ausilon/VLSI-Design/README.md

# VLSI Implementation of DPD for Next-Generation Digital TV Transmitters

Este repositório reúne o desenvolvimento de um sistema de pre-distorção digital
(Digital Predistortion, DPD) para transmissores de televisão digital de próxima
geração. O trabalho parte da geração de sinais OFDM em banda-base, passa pela
modelagem e treinamento do DPD, avança para a implementação em HDL e termina em
uma avaliação física preliminar com OpenLane e SKY130.

A motivação principal é estudar uma arquitetura digital capaz de compensar as
não linearidades de um amplificador de potência em um transmissor de TV digital.
O alvo de validação adotado é um sinal de canal de 6 MHz, representado como
banda-base complexa I/Q em 24 MS/s. Essa escolha permite trabalhar com uma taxa
compatível com o processamento digital do sinal e, ao mesmo tempo, manter margem
para observar distorções espectrais relevantes para DPD.

O projeto utiliza predominantemente ferramentas abertas e ferramentas acessíveis
em ambiente acadêmico. A geração de sinais foi feita com GNU Radio, a etapa de
treinamento utilizou OpenDPD, a verificação HDL foi conduzida no Questa Intel
FPGA Edition e a avaliação física foi preparada com OpenLane, OpenROAD, Yosys,
Magic, KLayout e o PDK aberto SKY130. Essa combinação foi adotada para permitir
reprodutibilidade, reduzir barreiras de acesso e manter o fluxo técnico
auditável por outros pesquisadores.

---

# Visão Geral do Fluxo

O fluxo foi organizado de forma incremental. Primeiro foi gerado um dataset em
banda-base complexa, usando uma cadeia ATSC 3.0 no GNU Radio como fonte de
excitação. Esse dataset foi convertido para os formatos usados tanto pelo
OpenDPD quanto pelos testbenches HDL. Em seguida, o OpenDPD foi usado para
treinar um modelo GMP e produzir coeficientes de referência. Esses coeficientes
foram quantizados em Q2.16 e aplicados ao motor HDL de inferência.

Na parte digital, o sistema foi dividido em três funções principais. O
`GMPengine` executa a inferência em tempo real e aplica a pre-distorção ao fluxo
I/Q. O `MetricEngine` observa potência, erro entre referência e feedback,
clipping e drift entre o sinal pre-distorcido e a referência. O `MACcore` executa
o treinamento interno em segundo plano, usando amostras capturadas da RAM e
atualizando o banco de coeficientes inativo.

Depois da validação funcional em simulação, os blocos foram preparados para
avaliação física em SKY130. A estratégia adotada foi modular: sintetizar e
avaliar primeiro os blocos menores, depois os blocos críticos de maior área
(`GMPengine` e `MACcore`) e, por fim, montar um top-level físico com macros.

---

# Organização do Repositório

A árvore pública mantém somente as versões finais selecionadas para revisão.
Versões intermediárias, diretórios de simulação compilados e runs completos de
OpenLane não são versionados. A evolução do trabalho é descrita nos documentos,
sem duplicar código antigo.

```text
Digital-Pre-Distortion/
├── HDL/
│   ├── rtl/          implementação HDL atual
│   ├── tb/           testbenches SystemVerilog
│   └── sim/          scripts Questa e vetores pequenos
├── gnu-radio/        flowgraph final usado para gerar o dataset ATSC 3.0
├── opendpd/          estudo algorítmico, contratos e figuras do treinamento
├── datasets/         datasets selecionados para reprodução
├── scripts/          conversão, quantização e exportação de coeficientes
├── openlane/         projetos OpenLane sem artefatos compilados
└── docs/             artigo, figuras, referências e estado técnico
```

---

# Geração do Dataset com GNU Radio

O dataset principal foi gerado a partir de uma cadeia ATSC 3.0 baseada no
projeto `gr-atsc3`, disponível em:

```text
https://github.com/drmpeg/gr-atsc3
```

O flowgraph usado como ponto de partida foi o exemplo `vv031.grc`. Ele foi
adaptado localmente para gerar um sinal em banda-base complexa adequado ao
treinamento DPD e à validação HDL. A entrada usada foi um arquivo de transporte
MPEG-TS (`sample_1280x720.ts`), e a saída foi convertida para amostras complexas
em 24 MS/s.

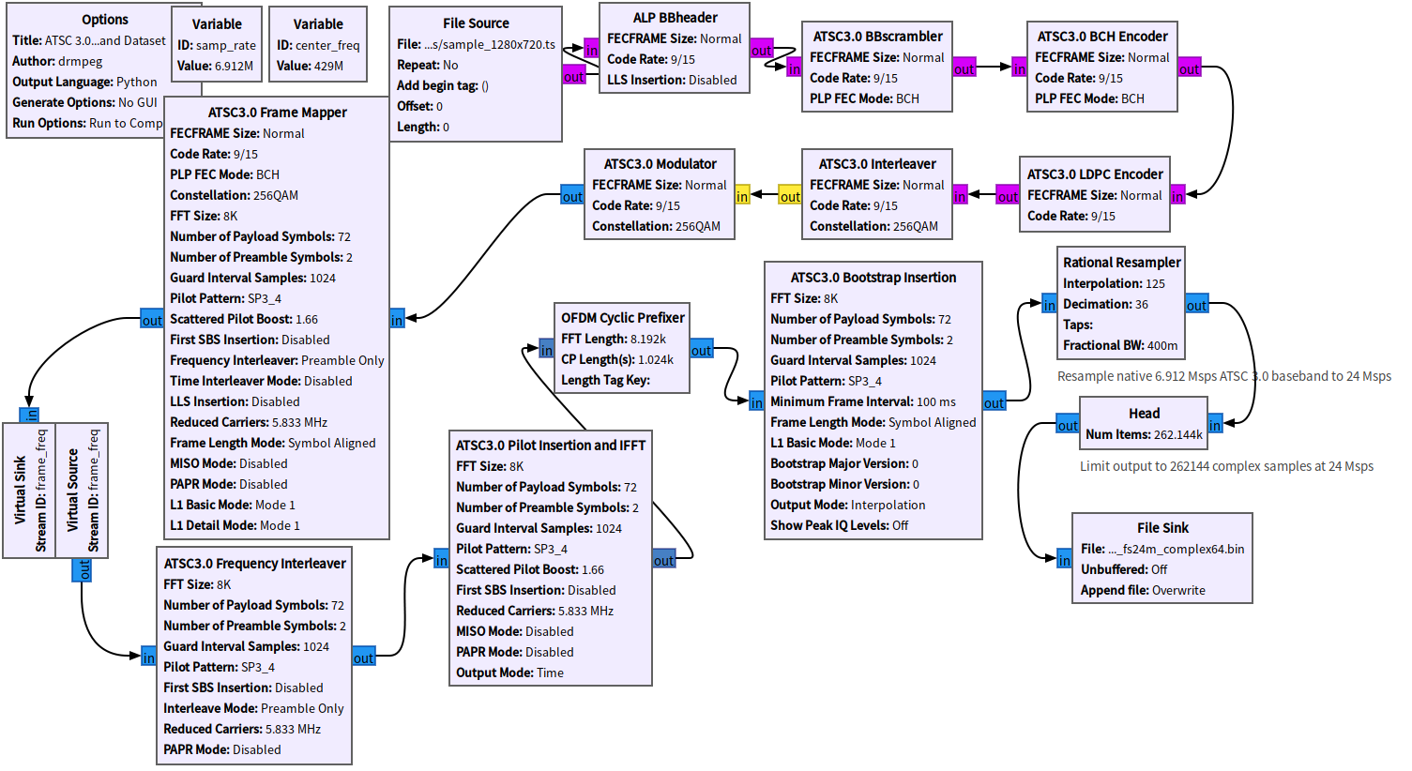
[picture p1: Digital-Pre-Distortion/docs/figures/gnuradio_atsc3_a322_vv031_flowgraph.png]
GNU Radio ATSC 3.0 flowgraph


O dataset resultante preserva os parâmetros principais do cenário estudado:
canal de 6 MHz, FFT 8K, modulação 256-QAM, amostragem de saída em 24 MS/s e
representação complexa I/Q. Para a simulação HDL, o mesmo sinal foi convertido
para Q1.15 e armazenado em arquivos `.hex`, mantendo nomes padronizados
(`ref_iq_q15.hex`, `feedback_iq_q15.hex` e capturas esperadas) para facilitar a
troca de datasets nos testbenches.

---

# Estudos Algorítmicos com OpenDPD

Antes da implementação em HDL, o comportamento do predistorter foi estudado no
ambiente OpenDPD. Essa etapa foi usada como referência matemática e experimental
para definir quais operações realmente precisariam existir no hardware. O fluxo
parte de um sinal I/Q em banda-base, passa esse sinal por um modelo de PA,
observa a distorção gerada e treina um bloco DPD para produzir uma versão
pre-distorcida da entrada. Quando essa versão pre-distorcida atravessa o mesmo
modelo de PA, a saída resultante deve se aproximar novamente do sinal linear
desejado.

No OpenDPD, essa separação deixa claro que existem dois problemas relacionados,
mas não idênticos. O primeiro é identificar ou aproximar o comportamento do PA.
O segundo é obter uma função inversa prática, isto é, um predistorter que
compense a compressão de ganho, a rotação de fase e os efeitos de memória do
amplificador. Para o trabalho em hardware, essa distinção foi importante porque
o PA completo não precisa ser implementado no caminho rápido do chip. O que
precisa operar em tempo real é o modelo DPD já treinado, enquanto a atualização
dos coeficientes pode ocorrer em background.

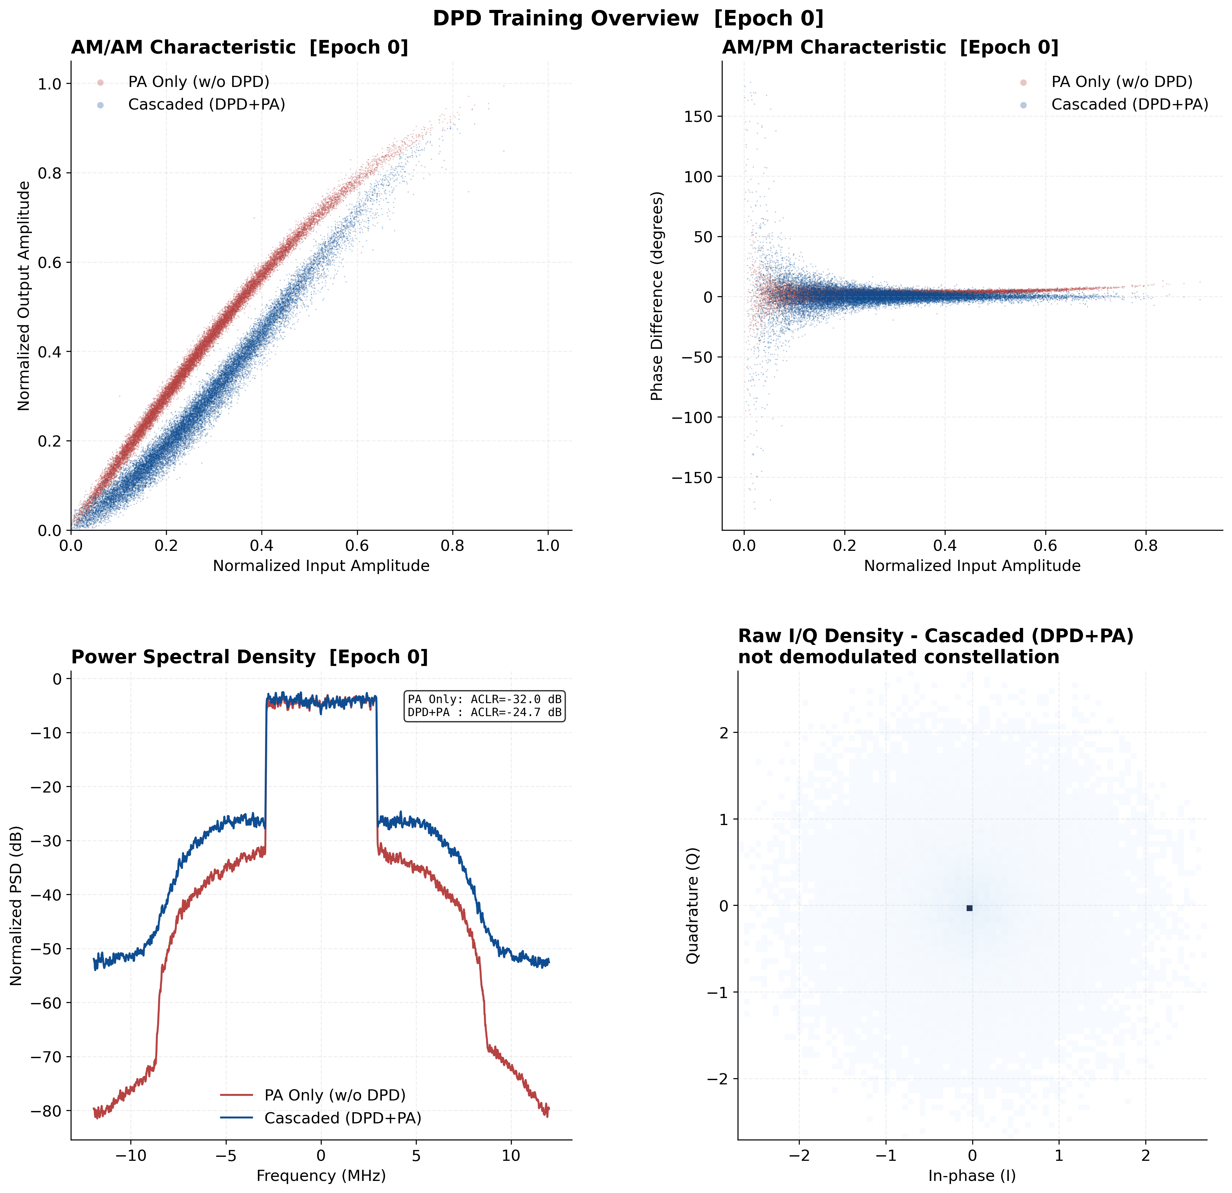
[picture p2: Digital-Pre-Distortion/opendpd/figures/overview_test.gif]
OpenDPD training overview


Os estudos iniciais compararam sinais DVB-T2 e ATSC 3.0, diferentes taxas de
amostragem e diferentes condições de PA. O resultado mais útil para a
arquitetura final veio do dataset ATSC 3.0/A/322 baseado no `vv031.grc`, com
saída em 24 MS/s. A escolha de 24 MS/s foi mantida porque representa quatro
vezes a largura do canal de 6 MHz, criando uma margem mais adequada para
observar componentes fora de banda e distorções de ordem mais alta. Nos testes
com banda passante menor, a resposta do DPD parecia melhorar algumas métricas,
mas a observabilidade espectral era limitada para uma análise robusta.

O algoritmo adotado para a sequência seguinte foi o GMP (Generalized Memory
Polynomial). Essa escolha equilibra três fatores. Primeiro, o GMP é uma família
de modelos conhecida em DPD para PAs com não linearidade e memória. Segundo, ele
é mais amigável para implementação digital que uma rede neural, pois pode ser
decomposto em atrasos, produtos, acumulações e bancos de coeficientes. Terceiro,
o próprio OpenDPD permitiu treinar e exportar uma configuração GMP que depois
poderia ser comparada contra a implementação HDL.

Na configuração registrada, o modelo de PA foi treinado como
`PA_S_0_M_GMP_H_23_F_64` e o predistorter como
`DPD_S_0_M_GMP_H_15_F_64_P_39`. O ponto mais importante para o HDL é o sufixo
`P_39`: ele consolidou a decisão de implementar 39 termos GMP. Como cada termo
usa coeficiente complexo, o contrato digital passou a exigir 39 pares de
coeficientes reais/imaginários, e não apenas coeficientes escalares reais. Essa
decisão aumentou a área do `GMPengine`, mas evitou validar uma versão
matematicamente mais fraca que não corresponderia ao modelo treinado no
OpenDPD.

O melhor resultado registrado para o dataset ATSC 3.0 em modo de PA mais
exigente ocorreu na época 12 de 15. O CSV final indicou, para validação,
`VAL_NMSE = -55,15 dB`, `VAL_EVM = -59,13 dB` e
`VAL_ACLR_AVG = -53,56 dB`. Para teste, os valores foram
`TEST_NMSE = -57,47 dB`, `TEST_EVM = -61,00 dB` e
`TEST_ACLR_AVG = -46,45 dB`. A diferença entre validação e teste no ACLR foi
mantida como observação de engenharia, pois o ACLR é sensível ao trecho do
sinal, à ocupação espectral instantânea e às janelas usadas na medição. Mesmo
assim, os resultados foram suficientes para definir o contrato algorítmico que
seria levado ao HDL.

A partir dessa etapa, os principais contratos definidos foram:

| Item | Contrato adotado no projeto |
|---|---|
| Amostras I/Q | signed Q1.15, 16 bits por componente |
| Coeficientes | signed Q2.16, 18 bits por componente |
| Modelo de inferência | GMP com 39 termos complexos |
| Dataset de referência | ATSC 3.0/A/322, 8K, 256-QAM, 24 MS/s |
| Entrada de simulação | arquivos `.hex` determinísticos para REF e FB |
| Saída esperada | vetores golden gerados a partir do modelo OpenDPD |
| Métricas de software | NMSE, EVM e ACLR |
| Métricas de hardware | potência L1, erro REF-FB, drift DPD-REF e clipping |

Essa tabela também explica por que os arquivos de simulação ainda carregam
referência e feedback separados. No transmissor físico, o feedback será obtido
da cadeia de observação após o PA. No ambiente de validação, entretanto, o
feedback precisa ser fornecido como arquivo para tornar a simulação reprodutível
e permitir checagem ciclo a ciclo. O uso de vetores golden também não significa
que o hardware dependa do OpenDPD em operação; ele significa apenas que uma
implementação HDL pode ser confrontada com uma referência algorítmica conhecida.

O OpenDPD também influenciou a divisão entre `GMPengine`, `MACcore` e
`MetricEngine`. O `GMPengine` implementa a inferência do modelo treinado e fica
no caminho rápido. O `MACcore` implementa o treinamento interno em tempo lento,
usando a RAM de captura e atualizando o banco de coeficientes inativo. O
`MetricEngine` não tenta reproduzir todas as métricas acadêmicas do OpenDPD em
tempo real. Ele calcula métricas mais simples e baratas em hardware, suficientes
para indicar degradação, clipping ou necessidade de novo treinamento. Métricas
como NMSE, EVM e ACLR continuam sendo adequadas para avaliação offline e
relatórios, mas seriam caras demais para colocar integralmente no caminho de
controle rápido de um ASIC compacto.

---

# Arquitetura Digital

O sistema inicia em bypass, pois no primeiro momento ainda não há coeficientes
válidos para compensar o PA. Enquanto o caminho rápido encaminha a referência, a
RAM de captura registra pares de referência e feedback. O `MACcore` utiliza esse
snapshot para treinar coeficientes. Quando o treinamento termina, o banco
inativo é atualizado e a troca de banco ocorre em evento síncrono, evitando
glitches no caminho de amostras.

Após a ativação do DPD, o `GMPengine` passa a operar no caminho rápido. O
`MetricEngine` continua acompanhando a qualidade do sinal e pode solicitar novo
treinamento quando as métricas ultrapassam os limiares configurados. O PicoRV32
permanece como elemento de controle e política, sem executar processamento
pesado de DSP.

O algoritmo de inferência é um GMP complexo. Para cada amostra central da janela
I/Q, o `GMPengine` calcula termos de base do tipo:

```text
phi_k[n] = x[n - m_x(k)] . |x[n - m_a(k)]|^p(k)
y[n]     = sum_k c_k . phi_k[n],  k = 0 ... 38
```

em que `x[n]` é a amostra complexa de referência, `c_k` é o coeficiente
complexo treinado e `p(k)` define a ordem não linear do termo. No HDL atual,
`x[n]` usa Q1.15, `c_k` usa Q2.16 e a saída é saturada novamente para Q1.15.

O treinamento interno usa uma forma block-NLMS por termo. A partir da captura
REF/FB, o `MACcore` monta a mesma base GMP e atualiza os coeficientes por:

```text
w_k <- w_k + mu . sum(e[n] . conj(phi_k[n])) /
             (epsilon + sum(|phi_k[n]|^2))
```

O `MetricEngine` usa métricas leves em hardware, sem FFT, divisão ou conversão
para dB. As principais são EWMA de magnitude L1 da saída DPD, EWMA do erro
REF-FB, EWMA do drift entre DPD e referência e contagem de clipping:

```text
power  <- power  - power/256  + (|dpd_i| + |dpd_q|)
error  <- error  - error/256  + (|ref_i - fb_i| + |ref_q - fb_q|)
drift  <- drift  - drift/256  + abs((|dpd_i| + |dpd_q|) - (|ref_i| + |ref_q|))
retrain_request = error > th_error or drift > th_drift or clipping > th_clip
```

O PicoRV32 executa a política de operação por meio de um mapa AXI-Lite. Pelo
firmware, ele pode habilitar o DPD e o bypass, iniciar captura e treinamento,
programar o alinhamento do feedback e os limiares das métricas, acessar os
bancos A/B, solicitar a troca sincronizada e consultar estados, métricas e
interrupções. O mapa completo de memória, registradores e campos está descrito
na seção [Mapa de Memória e Registradores do Subsistema
DPD](Digital-Pre-Distortion/HDL/README.md#mapa-de-memória-e-registradores-do-subsistema-dpd).

```text
bypass inicial
-> captura REF/FB
-> treinamento no MACcore
-> escrita no banco de coeficientes inativo
-> troca sincronizada de banco
-> inferência em tempo real no GMPengine
-> métricas e possível retreinamento
```

---

# Síntese Física e OpenLane

O fluxo físico foi estruturado por macros, seguindo a mesma estratégia modular
do HDL. Os blocos de controle e periféricos foram sintetizados separadamente,
enquanto RAM de captura e bancos de coeficientes foram tratados como macros com
SRAM. Essa separação evita que memórias grandes sejam implementadas
integralmente em flip-flops e permite estudar a ocupação física de cada bloco.

O `GMPengine` é o bloco de maior pressão de timing porque pertence ao caminho
rápido. A versão atual para OpenLane mantém os 39 termos GMP complexos,
amostras Q1.15 e coeficientes Q2.16. Dez lanes processam quatro grupos de termos,
resultando em intervalo de iniciação de quatro ciclos e throughput de
`Fclk/4`. Cada lane possui contrato de latência fixa e pipeline separado para
base GMP, produto, combinação complexa e alinhamento de saída. Em 100 MHz, essa
arquitetura fornece nominalmente 25 MS/s, acima do requisito de 24 MS/s. Esse é
o contrato arquitetural; a frequência física final depende do fechamento STA RCX
multicorner.

O `MACcore` usa a mesma base GMP no caminho lento e executa a atualização NLMS
sobre snapshots da RAM. A serialização é mais intensa porque o treinamento não
participa do datapath em tempo real. Após o registro da fronteira de leitura da
Capture RAM, a FSM recebeu dois ciclos explícitos de espera antes de consumir
cada palavra. O testbench golden foi repetido após essa alteração.

As duas memórias foram preparadas com fronteiras registradas, pin placement
orientado pelos ports das SRAMs e CTS específico. Elas possuem resultados
físicos posteriores ao global routing, mas esses resultados não são promovidos
isoladamente a signoff enquanto as oito macros não forem avaliadas no mesmo
checkpoint e com constraints completas.

O top-level experimental contém conectividade funcional entre as oito macros,
FIFOs elásticas nas fronteiras críticas, plano AXI-Lite interno e PDN
hierárquica. A baseline física publicada mantém die de `8,5 x 8,5 mm` e
clock-alvo de 100 MHz. As tentativas de integração do top ainda não produziram
fechamento uniforme de STA RCX multicorner. O contrato de encapsulamento
continua prevendo `aQFN/DRQFN-128`, mas o padframe físico, a análise de IR drop,
potência e o signoff do chip não fazem parte da baseline atual.

O floorplan foi refinado a partir de uma proposta manual de organização de
macros. A intenção foi manter o caminho rápido próximo ao `GMPengine`, posicionar
RAM e bancos de coeficientes entre inferência e treinamento, deixar o `MACcore`
na região inferior do núcleo e agrupar controle, métricas e periféricos na
lateral esquerda. Essa distribuição reduz cruzamentos desnecessários entre
datapath e controle e deixa espaço para uma futura etapa de padframe.

<table>
  <tr>
    <td align="center" width="50%">
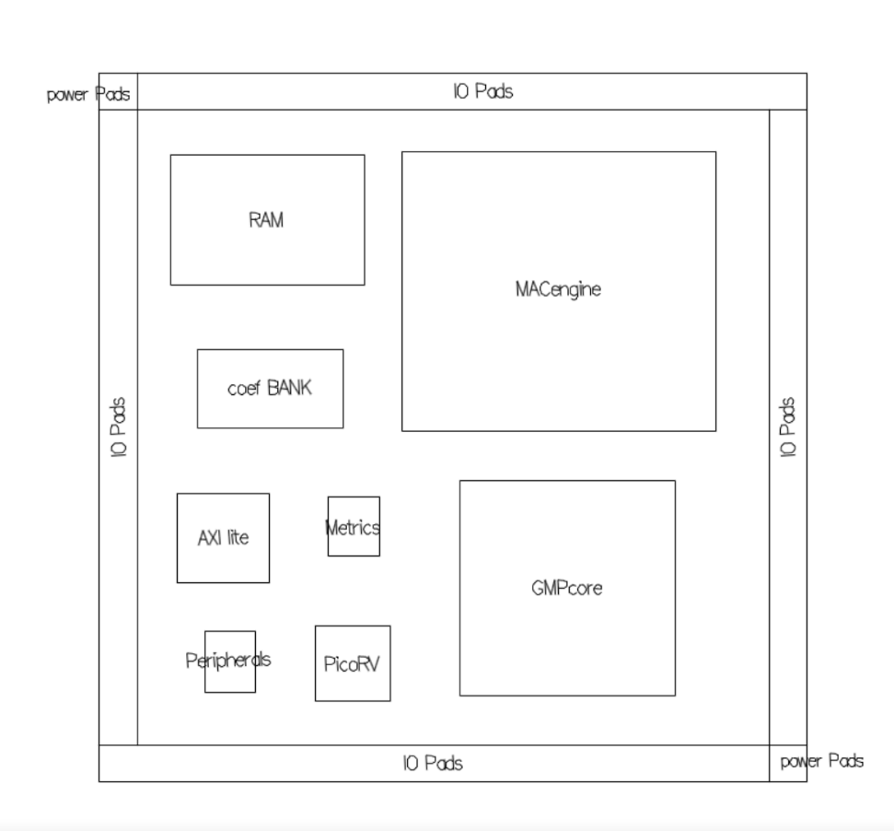
[picture p3: Digital-Pre-Distortion/docs/figures/dpd_foorplan.png]
      <br>
      <sub>Floorplan manual preliminar (<a href="Digital-Pre-Distortion/docs/figures/dpdv1_foorplan.pdf">PDF</a>).</sub>
    </td>
    <td align="center" width="30%">
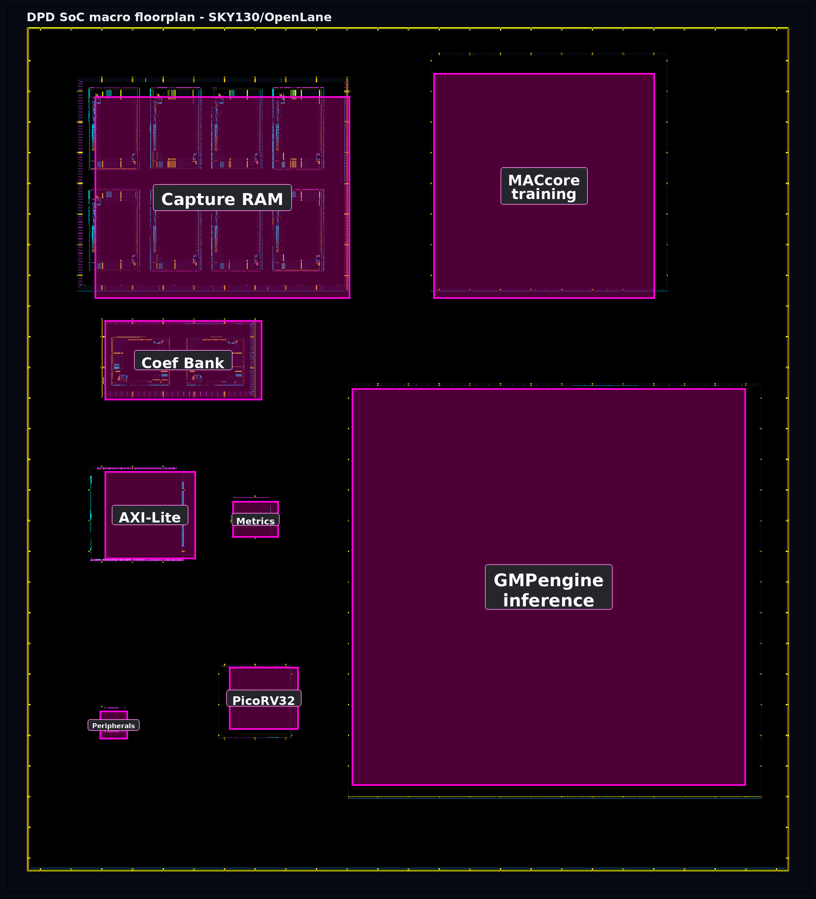
[picture p4: Digital-Pre-Distortion/docs/figures/dpd_soc_top_floorplan_v4.png]
      <br>
      <sub>Floorplan V4 usado como referência para a integração física (<a href="Digital-Pre-Distortion/docs/figures/dpd_soc_top_floorplan_v4.pdf">PDF</a>).</sub>
    </td>
  </tr>
</table>

A comparação seguinte foi nivelada no último checkpoint comum comprovado para
as oito macros: síntese mapeada, CTS, global routing e STA single-corner
pós-global-route com período-alvo de 10 ns. As contagens e a célula dominante
foram extraídas das netlists mapeadas pelo Yosys.

| Macro | Run auditado | Células | Área macro (mm²) | Setup pós-GRT (ns) | Hold pós-GRT (ns) | Dominante Cell |
|---|---|---:|---:|---:|---:|---|
| PicoRV32 | `signoff_100m_01` | 10.114 | 0,377 | +3,41 | +0,15 | `sky130_fd_sc_hd__buf_1` (2.422) |
| AXI control | `signoff_100m_01` | 1.713 | 0,640 | +3,58 | +0,21 | `sky130_fd_sc_hd__buf_1` (395) |
| Peripherals | `signoff_100m_01` | 755 | 0,044 | +4,21 | +0,19 | `sky130_fd_sc_hd__dfrtp_2` (183) |
| MetricEngine | `signoff_100m_01` | 2.593 | 0,116 | +2,94 | +0,24 | `sky130_fd_sc_hd__nand2_2` (272) |
| Capture RAM | `capture_ram_signoff_100m_13` | 741 (inclui 8 SRAM) | 4,140 | +3,93 | +0,26 | `sky130_fd_sc_hd__dfxtp_2` (320) |
| Coef Bank | `coef_bank_signoff_100m_04` | 154 (inclui 2 SRAM) | 0,845 | +1,84 | +1,65 | `sky130_fd_sc_hd__buf_1` (56) |
| GMPengine | `gmp_feature_piped_route_relaxed_100m_01` | 223.170 | 11,497 | +3,16 | +0,09 | `sky130_fd_sc_hd__nand2_2` (79.930) |
| MACcore | `mac_core_100m_05` | 131.048 | 7,758 | +1,47 | +0,16 | `sky130_fd_sc_hd__nand2_2` (35.921) |

## Resultado físico consolidado em 100 MHz

| Item | Resultado |
|---|---:|
| Clock-alvo das macros | 100 MHz (`10 ns`) |
| Checkpoint comum | STA single-corner pós-global-route |
| Macros niveladas | 8 |
| Menor setup observado | +1,47 ns (`MACcore`) |
| Menor hold observado | +0,09 ns (`GMPengine`) |
| GMPengine | `II=4`, throughput nominal de 25 MS/s a 100 MHz |
| Signoff uniforme do top | Não demonstrado |

Esses valores representam o melhor resultado comparável das macros isoladas no
alvo de 100 MHz. Eles não são combinados com resultados de runs posteriores em
outros períodos de clock e não demonstram que o top-level tenha fechado
temporização. O fechamento do top permanece dependente de constraints completas
e STA extraído multicorner.

Todas as oito macros possuem uma baseline comparável no checkpoint
pós-global-route. Resultados adicionais de detailed route, DRC, LVS e XOR
permanecem como evidências individuais e não são usados para elevar
seletivamente uma linha da tabela. Também não se declara Fmax a partir de WNS
intermediário: a frequência de operação será consolidada somente depois de
completar constraints e STA extraído multicorner na baseline física aprovada ou
no chip completo.

---

# Documentação Principal

- [Fluxo DPD](Digital-Pre-Distortion/README.md)
- [Arquitetura HDL](Digital-Pre-Distortion/HDL/README.md)
- [GNU Radio](Digital-Pre-Distortion/gnu-radio/README.md)
- [OpenDPD](Digital-Pre-Distortion/opendpd/README.md)
- [Datasets](Digital-Pre-Distortion/datasets/README.md)
- [OpenLane/SKY130](Digital-Pre-Distortion/openlane/README.md)
- [Trabalhos futuros](Digital-Pre-Distortion/docs/future_work.md)

---

# Política de Versionamento

O repositório mantém arquivos necessários para análise e reprodução do fluxo:
HDL, testbenches, scripts, flowgraphs, metadados, datasets selecionados,
configurações OpenLane e documentação. Não são versionados diretórios `runs/`,
bibliotecas `work/`, arquivos `.wlf`, GDS/LEF/DEF/SPICE/SDF/LIB gerados, logs
longos, caches e binários compilados.
