ausilon/VLSI-Design/Digital-Pre-Distortion/docs/figures/dpd_soc_top_floorplan_v4.pdf

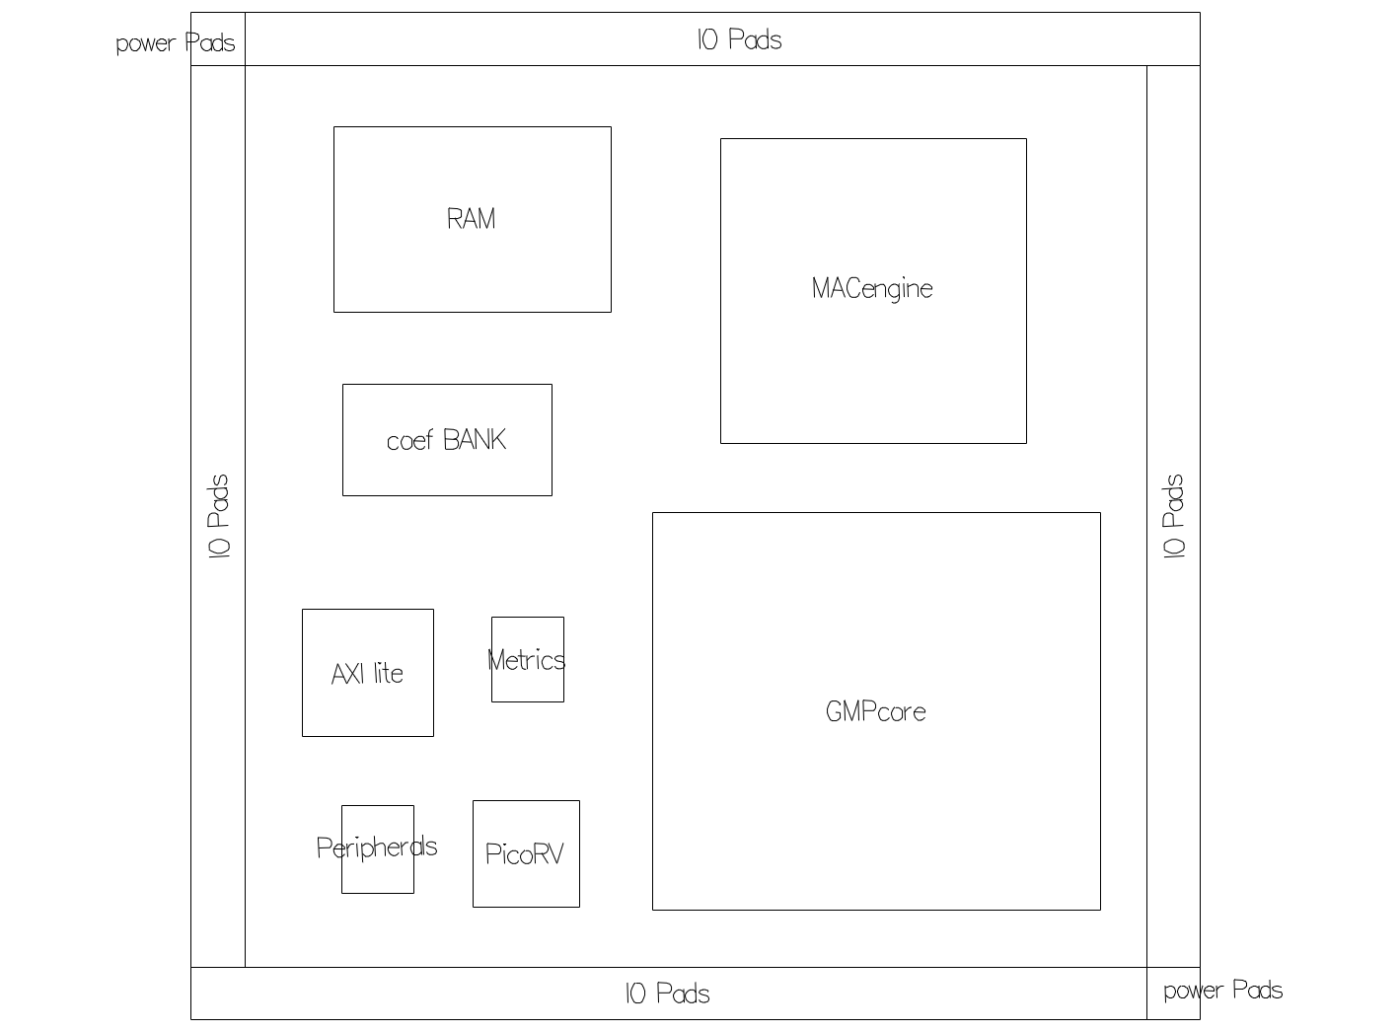
[picture p5: page 1]
