ausilon/VLSI-Design/Digital-Pre-Distortion/docs/figures/dpdv1_foorplan.pdf

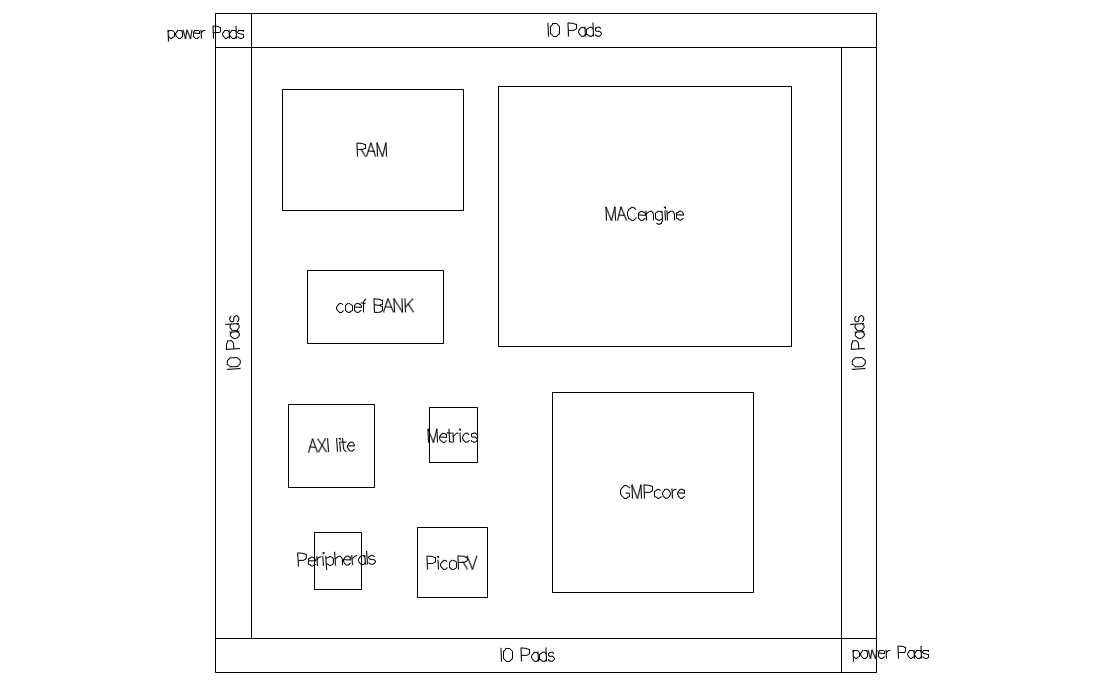
[picture p6: figure]
