ausilon/VLSI-Design/Digital-Pre-Distortion/article/VLSI_Implementation_of_DPD_for_Next_Generation_Digital_TV_Transmitters.pdf

# VLSI Implementation of DPD for Next-Generation Digital TV Transmitters

Ausilon V. Souza, Tarciso Gregório B. de Bello ausilon.souza@mtel.inatel.br, tarciso.gregorio@mtel.inatel.br Instituto Nacional de Telecomunicações – INATEL

Resumo—Este artigo apresenta o desenvolvimento de uma arquitetura HDL para Pré-Distorção Digital (Digital Predistortion – DPD) aplicada a transmissores de televisão digital de próxima geração. O trabalho considera como alvo tecnológico o contexto da TV 3.0 brasileira e adota, como sinal de referência inicial, uma forma de onda OFDM compatível com a família ATSC 3.0/A/322, canal de 6 MHz, modulação 256-QAM, FFT 8K e taxa de amostragem de 24 MS/s. A metodologia integra geração de dataset em GNU Radio, estudo algorítmico em OpenDPD, validação HDL no Questa e avaliação física preliminar em SKY130 por meio do OpenLane. O algoritmo adotado é um Generalized Memory Polynomial (GMP) com 39 termos complexos, amostras em ponto fixo Q1.15 e coeficientes em Q2.16. A arquitetura separa o caminho rápido de inferência, implementado pelo GMPengine, do caminho lento de captura, treinamento NLMS, atualização de coeficientes e supervisão por métricas. Os resultados consolidam o contrato algoritmo–HDL, demonstram validação funcional dos blocos críticos e apresentam uma baseline física comparável para oito macros no alvo de 100 MHz. A integração física final do top-level, o padframe com proteção ESD e o fechamento temporal pós-extração permanecem como trabalhos futuros.

Index Terms—Digital Predistortion, DPD, VLSI, Digital TV, TV 3.0, ATSC 3.0, GMP, NLMS, HDL, SKY130, OpenLane, GNU Radio, OpenDPD.

I. INTRODUÇÃO
O

trabalho apresentado neste artigo propõe o desenvolvimento de um hardware dedicado para aplicações em telecomunicações, com foco específico na implementação de um sistema de Pré-Distorção Digital (Digital Predistortion – DPD). A arquitetura desenvolvida foi concebida considerando os requisitos impostos pelos sistemas de radiodifusão de televisão digital de nova geração, em especial o padrão TV 3.0, cuja adoção representa um importante avanço tecnológico ao incorporar novas técnicas de modulação, codificação e transmissão de sinais. Nesse contexto, a crescente complexidade dos algoritmos de processamento digital de sinais exige soluções computacionais capazes de operar em tempo real, com elevada eficiência energética e reduzida latência, tornando o desenvolvimento de arquiteturas dedicadas uma alternativa de grande relevância para aplicações práticas.
Uma das premissas fundamentais deste trabalho consiste na adoção de um fluxo de desenvolvimento baseado predominantemente em ferramentas, frameworks e ambientes de desenvolvimento de código aberto. Essa escolha está diretamente relacionada à necessidade de tornar o processo de pesquisa mais acessível, transparente e reprodutível. No campo da microeletrônica e do projeto de circuitos integrados, grande parte das ferramentas de projeto eletrônico (Electronic Design Automation – EDA) é disponibilizada apenas por meio de licenças comerciais de alto custo, geralmente restritas a grandes empresas e centros de pesquisa. Essa realidade representa uma barreira significativa para universidades, laboratórios independentes e pesquisadores, limitando o acesso às tecnologias mais modernas e dificultando a formação de novos profissionais na área.

Nos últimos anos, entretanto, observa-se um crescimento expressivo do ecossistema de ferramentas abertas para projeto de hardware digital. Esse movimento tem possibilitado a realização de fluxos completos de desenvolvimento utilizando soluções livres, abrangendo desde a descrição do hardware até as etapas de síntese lógica, posicionamento físico, roteamento, geração de layout e verificação do projeto. Além de reduzir custos, essa abordagem favorece a reprodutibilidade científica, permitindo que outros pesquisadores validem, reproduzam e estendam os resultados apresentados.

No fluxo de desenvolvimento adotado neste trabalho, a descrição do hardware foi realizada utilizando linguagem HDL, empregando ferramentas da Siemens EDA disponibilizadas por meio de licença acadêmica estudantil para validação funcional. Após a descrição do hardware, as etapas de síntese lógica, planejamento físico, posicionamento, roteamento e verificação física foram avaliadas utilizando o framework OpenLane, que integra ferramentas como Yosys, OpenROAD, Magic e Netgen ao PDK aberto SKY130 [1], [2]. A modelagem comportamental do amplificador de potência e o treinamento do DPD foram conduzidos no OpenDPD [3], [4], enquanto a geração do sinal em banda-base foi feita em GNU Radio [5], a partir de uma cadeia ATSC 3.0 disponível no projeto gr-atsc3 [6].

A integração dessas ferramentas demonstra que é possível estabelecer um fluxo completo de desenvolvimento para sistemas de processamento digital de sinais voltados às telecomunicações utilizando predominantemente tecnologias abertas. Além de reduzir custos, essa abordagem promove maior transparência metodológica, facilita a reprodutibilidade dos experimentos e incentiva a colaboração entre pesquisadores. Dessa forma, o presente trabalho busca apresentar uma arquitetura dedicada para implementação de DPD aplicada ao contexto da TV 3.0 e, simultaneamente, registrar os contratos algorítmicos, numéricos e físicos necessários para levar esse tipo de algoritmo a uma implementação VLSI.

II. OBJETIVO E CONTRIBUIÇÕES
O objetivo principal deste trabalho é desenvolver e validar uma arquitetura HDL de DPD capaz de operar como bloco dedicado em um transmissor de televisão digital de próxima geração. Nesta etapa, o foco é consolidar a transição entre o algoritmo treinado em alto nível e uma implementação sintetizável, com atenção especial à quantização, ao particionamento entre caminho rápido e caminho lento, à validação por testbenches e à estimativa física em SKY130.
As principais contribuições desta versão do trabalho são:
- definição de um fluxo de dataset para DPD baseado em GNU Radio e em forma de onda ATSC 3.0/A/322, com canal de 6 MHz e taxa de 24 MS/s;
- estudo algorítmico em OpenDPD para seleção de um modelo GMP com 39 termos complexos e avaliação por NMSE, EVM e ACLR;
- consolidação do contrato numérico em Q1.15 para amostras I/Q e Q2.16 para coeficientes complexos;
- implementação HDL dos blocos GMPengine, MACcore com treinamento block-NLMS e MetricEngine com métricas L1/EWMA;
- validação funcional em Questa com vetores derivados do OpenDPD e testbenches de integração;
- avaliação física preliminar em OpenLane/SKY130, nivelando oito macros individuais no checkpoint comum de STA single-corner pós-global-route com alvo de 100 MHz.

III. SINAL DE REFERÊNCIA E DATASET

A especificação brasileira TV 3.0 é tratada neste trabalho como alvo tecnológico de longo prazo. Os documentos do Fórum SBTVD e os relatórios da fase 3 indicam a adoção de uma camada física compatível com a família ATSC 3.0, incluindo conceitos presentes nos documentos A/300, A/321, A/322 e A/324 [7]–[13]. A norma brasileira ABNT NBR 25601:2025 aparece como referência formal de camada física no catálogo da ABNT [14].
Para avançar antes da disponibilidade de uma cadeia completa de transmissão TV 3.0 em hardware, foi adotado um sinal OFDM de referência inspirado no perfil físico ATSC 3.0/A/322. O dataset principal foi gerado no GNU Radio a partir do projeto gr-atsc3, usando como base o exemplo vv031.grc. Esse fluxo inclui blocos de processamento típicos da cadeia física, como scrambler, codificação BCH/LDPC, interleaving, mapeamento, inserção de pilotos, bootstrap e formação OFDM. A entrada utilizada foi um arquivo de transporte MPEG-TS, e a saída foi salva como banda-base complexa. A figura do flowgraph completo foi omitida nesta versão por legibilidade, mas o papel técnico da cadeia permanece o mesmo: produzir um estímulo I/Q compatível com o cenário de radiodifusão estudado e reprodutível por terceiros no GNU Radio.
O dataset final possui FFT 8K, modulação 256-QAM, canal de 6 MHz e taxa de saída de 24 MS/s. A taxa de 24 MS/s foi escolhida por representar quatro vezes a largura de canal de 6 MHz, oferecendo margem para observar componentes fora de banda e distorções não lineares relevantes ao DPD.

Após a geração em ponto flutuante, o sinal foi convertido para arquivos usados pelo OpenDPD e para arquivos .hex em Q1.15 usados nos testbenches HDL. Em simulação, os arquivos de referência e feedback são mantidos separados para tornar o experimento determinístico; em hardware real, o feedback será produzido pela cadeia de observação após o PA.

IV. ESTUDO ALGORÍTMICO COM OPENDPD
Antes da implementação HDL, o OpenDPD foi utilizado como ambiente de referência para estudar o comportamento do PA e do predistorter. Essa etapa separa dois problemas: identificar ou aproximar a resposta do amplificador e obter uma função inversa prática capaz de compensar compressão de ganho, rotação de fase e efeitos de memória. O PA completo não é implementado no caminho rápido do chip; o que precisa operar em tempo real é o modelo DPD treinado, enquanto a atualização dos coeficientes pode ocorrer em background.
O algoritmo selecionado foi o Generalized Memory Polynomial (GMP). A escolha foi motivada por três fatores. Primeiro, o GMP é uma classe conhecida para DPD em PAs com não linearidade e memória. Segundo, sua estrutura pode ser implementada com atrasos, magnitudes, produtos complexos e acumulações, o que é mais direto para HDL do que modelos neurais densos. Terceiro, o OpenDPD permitiu treinar e exportar uma configuração GMP que pôde ser comparada contra a implementação inteira em hardware.
Na configuração consolidada, o PA foi treinado como PA_S_0_M_GMP_H_23_F_64 e o predistorter como DPD_S_0_M_GMP_H_15_F_64_P_39. O parâmetro P_39 definiu a implementação de 39 termos GMP. Como cada termo utiliza coeficiente complexo, a arquitetura passou a exigir pares real/imaginário para cada coeficiente, e não apenas coeficientes reais escalares.
O melhor ponto registrado ocorreu na época 12 de 15. A Tabela I mostra os resultados extraídos do CSV final. A diferença entre validação e teste no ACLR foi mantida como observação técnica, pois o ACLR é sensível ao trecho temporal avaliado, à ocupação espectral instantânea e à janela de medição.

Tabela I: Resultados do DPD GMP no OpenDPD para o dataset ATSC 3.0/A/322.

Conjunto | NMSE (dB) | EVM (dB) | ACLR médio (dB)
Validação | -55.15 | -59.13 | -53.56
Teste | -57.47 | -61.00 | -46.45
V. ARQUITETURA DIGITAL PROPOSTA
A Fig. 2 apresenta a arquitetura funcional. O sistema foi estruturado em dois caminhos. O caminho rápido contém o GMPengine, responsável pela inferência DPD em tempo real. O caminho lento contém captura de amostras, treinamento, atualização dos bancos de coeficientes e supervisão. Essa separação evita que o treinamento, que pode demandar janelas temporais muito maiores que o período de amostragem, interfira no fluxo contínuo de transmissão.

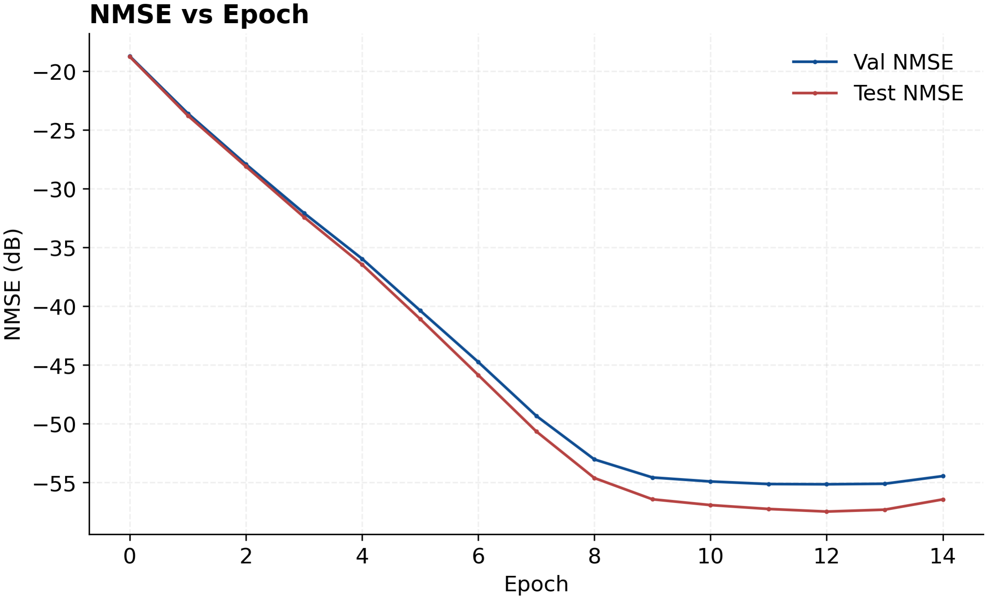
[picture p7: figure]
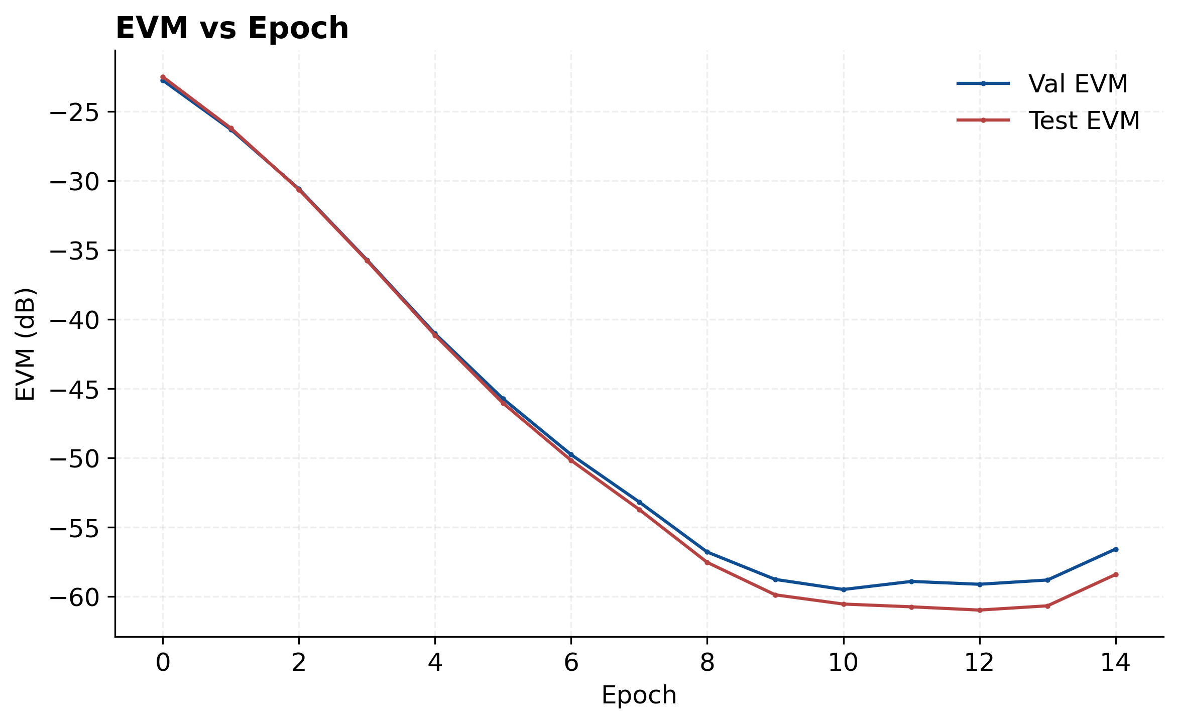
[picture p8: figure]
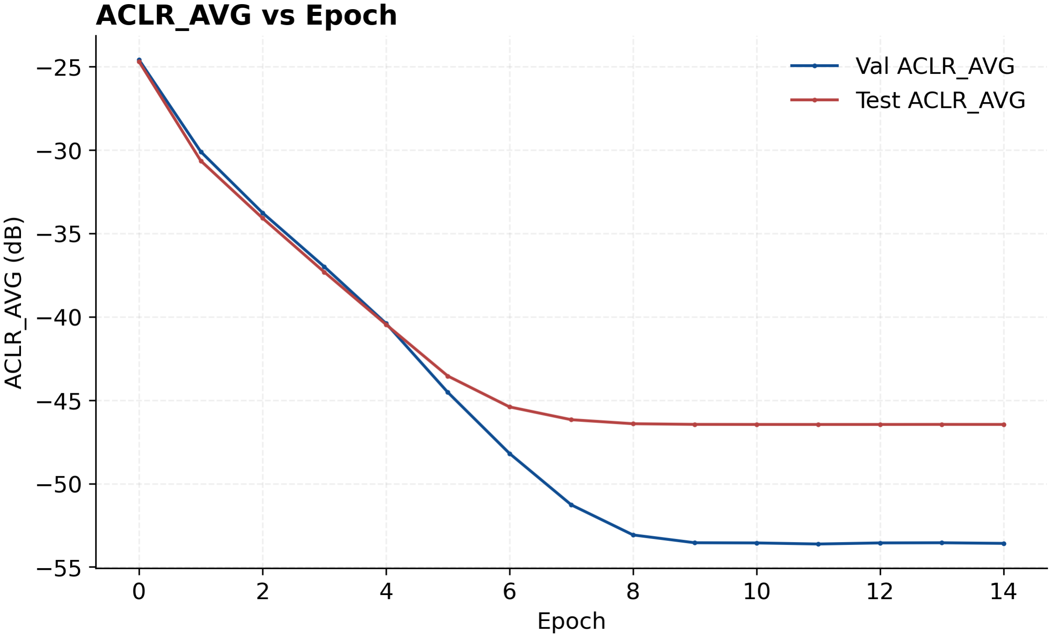
[picture p9: figure]

(a) NMSE por época. | (b) EVM por época. | (c) ACLR médio por época.

Figura 1: Curvas de treinamento obtidas no OpenDPD para o dataset ATSC 3.0/A/322 8K 256-QAM em 24 MS/s.

No diagrama, o bloco PA representa uma abstração do
caminho de transmissão analógico/RF observado pelo sistema de DPD. Portanto, além do amplificador de potência propriamente dito, esse bloco inclui efeitos equivalentes de conversão digital-analógica, filtragem de reconstrução, upconversion, cadeia RF, acoplamento de feedback, downconversion e conversão analógico-digital, quando observados no domínio de banda-base complexa. O modelo usado pelo DPD não busca descrever cada estágio físico individualmente, mas a relação comportamental equivalente entre o sinal de referência aplicado ao transmissor e o sinal de feedback medido após a cadeia RF.

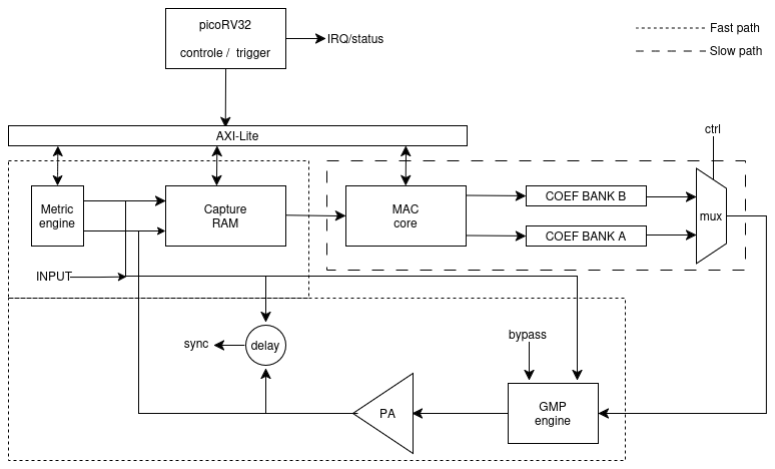
[picture p10: figure]

Figura 2: Diagrama funcional da arquitetura DPD com caminho rápido de inferência e caminho lento de captura/treinamento.

Durante a inicialização, o transmissor opera em bypass porque ainda não há coeficientes treinados. Nessa fase, a RAM de captura registra pares de referência e feedback. O MACcore lê esse snapshot e executa treinamento block-NLMS sobre a mesma base GMP usada na inferência. Ao final do treinamento, os coeficientes são gravados no banco inativo. A troca de banco ocorre apenas em evento de sincronismo, evitando descontinuidade no caminho de amostras.

VI. FORMULAÇÃO MATEMÁTICA PARA HDL

As amostras complexas são representadas por

x[n] = xi[n] + jxq [n], | (1)

com componentes signed Q1.15. Os coeficientes complexos do DPD são
ck = ak + j bk, | (2)

armazenados em signed Q2.16. Cada termo GMP ocupa dois endereços no banco de coeficientes:

addr(2k) = ℜ{ck }, | addr(2k + 1) = ℑ{ck }. | (3)
A. GMPengine
O modelo implementado pelo GMPengine é:

y[n] =

Õ
38

k=0

ckφk [n], | (4)

em que
φk [n] = xmx (k) [n]
xma (k) [n]
p(k)
| | | | | . | (5)
O | bloco | utiliza | uma janela | de | cinco | amostras
{x0, x1, x2, x3, x4}, sendo x2 | a amostra central associada
à saída validada. As posições x3 e x4 preservam o lookahead de duas amostras herdado do contrato OpenDPD. O conjunto de termos possui três termos lineares, com p = 0, e 36 termos não lineares, com p = 1, 2, 3, 4. Para cada ordem não linear são usadas nove combinações de posição:

(mx, ma) ∈ {(0, 0), (1, 1), (2, 2),
(0, 1), (1, 2), (2, 3),
(0, 2), (1, 3), (2, 4)}.
| | | | | | (6)

A magnitude é calculada por raiz inteira:

|xm| =

q

x

2
i,m + x

2
q,m, | (7)

e as potências são mantidas em escala Q1.15. Para p > 0,

φi =

xi,mx

|xma

p

2

15 | , | φq =

xq,mx

|xma

p

2

15 | . | (8)

A multiplicação complexa de cada termo é:

yi ← yi +

φiak − φqbk

2

16 | ,

yq ← yq +

φibk + φqak

2

16 | .

(9)

O deslocamento por 2

16 corresponde à escala Q2.16 dos coeficientes. Após a soma dos 39 termos, a saída é saturada para Q1.15.

B. MACcore e Block-NLMS

O MACcore usa o feedback como base de regressão e a referência como alvo. Para cada amostra capturada,

φk [n] = f bmx (k) [n]

f bma (k) [n]
p(k)
. | (10)

O modelo corrente estima:

yˆ[n] =

Õ
38

k=0

wkφk [n], | (11)

e o erro de modelo é:

e[n] = re f [n] − yˆ[n]. | (12)

Para cada termo, o treinamento acumula:

Nk =

Õ

n

e[n]φ

∗
k
[n], | (13)

Dk =

Õ

n

|φk [n]|²
. | (14)

A atualização block-NLMS aplicada é:
wk ← satQ2.16

wk + μ

Nk

ε + Dk

. | (15)

No HDL atual, ε = 1 e μ = 1/4, implementado por deslocamento de dois bits. O treinamento executa até 20 épocas, mantendo o melhor conjunto de coeficientes pela norma L1 do erro:

Ee pocℎ =

Õ

n

(|ℜ{e[n]}| + |ℑ{e[n]}|) . (16)

Após pelo menos 10 épocas, o treinamento pode parar antecipadamente caso o erro da época atual fique pior que o melhor erro observado.

C. MetricEngine

O MetricEngine calcula métricas leves, sintetizáveis e adequadas ao plano de controle. A magnitude L1 da saída DPD é:

magd pd [n] = |dpdi[n]| + |dpdq [n]|. | (17)

O erro REF-FB é:

errL1 [n] = |re fi[n] − f bi[n]| + |re fq [n] − f bq [n]|. (18)

O drift entre esforço de predistorção e referência é:

dri f tL1 [n] =

magd pd [n] − (|re fi[n]| + |re fq [n]|)
. (19)

As métricas são atualizadas por EWMA com fator 1/256:

M ← M −

M
256 + v[n]. | (20)

Esses valores não são expressos em dB; em regime permanente, aproximam 256 vezes a média L1 do sinal observado. O pedido de retreinamento é gerado por:

retrain = metrics_valid ∧ (metric_error > tℎe∨

metric_dri f t > tℎd∨ metric_cli p ping > tℎc). | (21)

VII. VALIDAÇÃO HDL

A validação foi conduzida no Questa, usando testbenches SystemVerilog. O fluxo foi construído de forma incremental: primeiro foram validados periféricos, bancos de coeficientes, captura e alinhamento; em seguida, os blocos críticos GMPengine, MetricEngine e MACcore; por fim, o fluxo completo em dpd_top.
O contrato OpenDPD–HDL foi validado por arquivos .hex. O banco coef_bank_openDPD.hex contém 78 palavras úteis, em formato real/imaginário, e margem até 128 posições. As amostras e saídas esperadas são armazenadas em Q1.15. O testbench do GMPengine carrega os coeficientes, aplica o dataset e compara a saída HDL com vetores calculados no mesmo modelo inteiro usado para validação. O teste integrado exercita a sequência:

bypass -> captura -> treino -> coeficientes -> sync -> DPD ativo -> métricas -> retreino.

A validação das métricas permite alternar entre DPD desabilitado e DPD ativo. Em bypass, a saída observada se aproxima da referência e as métricas de drift tendem a valores baixos. Com DPD ativo, as métricas passam a observar o esforço de predistorção aplicado pelo GMPengine. Essa separação é importante porque o sinal DPD não deve ser idêntico à referência antes do PA; ele deve ser intencionalmente pre-distorcido para que a saída após o PA se aproxime do comportamento linear desejado.

VIII. AVALIAÇÃO FÍSICA EM SKY130

Para avaliação física, o projeto foi reorganizado em macros OpenLane. Blocos menores, como PicoRV32, AXI-Lite, periféricos e MetricEngine, foram sintetizados individualmente. A RAM de captura e os bancos de coeficientes foram tratados como macros com SRAM, evitando implementação de grandes memórias em flip-flops. Os blocos críticos GMPengine e MACcore receberam versões específicas para reduzir área e pressão de roteamento, preservando o contrato funcional validado em simulação.
O GMPengine é o bloco de maior pressão temporal por pertencer ao caminho rápido. Na versão OpenLane atual, ele usa dez lanes pipelineadas e intervalo de iniciação de quatro ciclos, preservando 39 termos complexos, amostras Q1.15 e coeficientes Q2.16. Com essa arquitetura, o throughput é Fclk/4; portanto, um clock de 100 MHz fornece nominalmente 25 MS/s, ligeiramente acima do requisito de 24 MS/s. O MACcore opera no caminho lento e foi mais serializado, priorizando área e roteabilidade em vez de latência mínima. Essa relação é um contrato arquitetural; a frequência final do chip depende de STA extraído do top-level completo.
Para evitar comparação entre estágios físicos distintos, a Tabela II usa exclusivamente o checkpoint comum de STA single-corner pós-global-route com período-alvo de 10 ns. Os slacks positivos referem-se aos caminhos restritos nesse checkpoint e não substituem STA RCX multicorner. Da mesma forma, as tags históricas dos runs não são usadas como

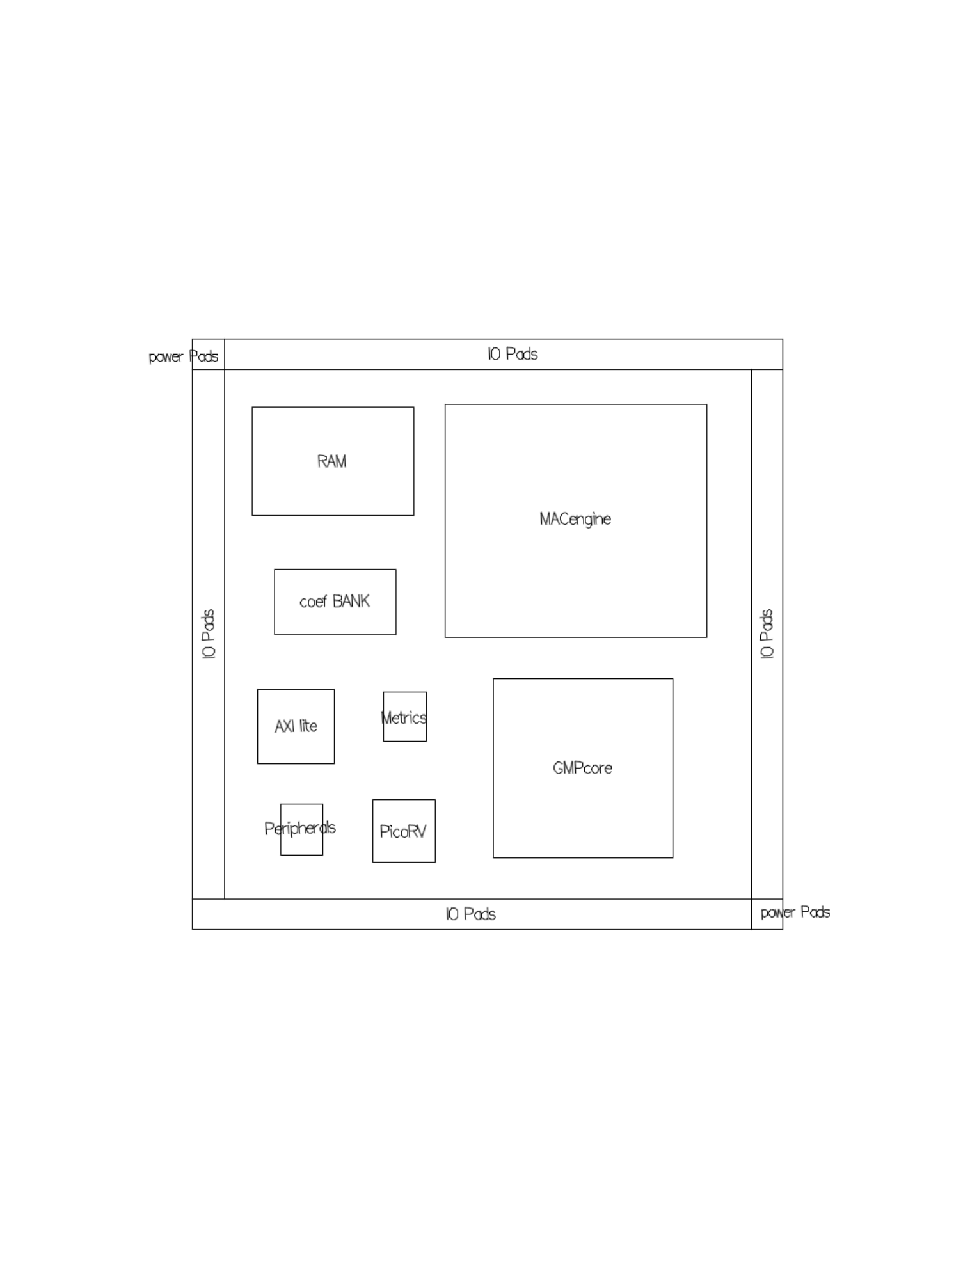
[picture p11: figure]
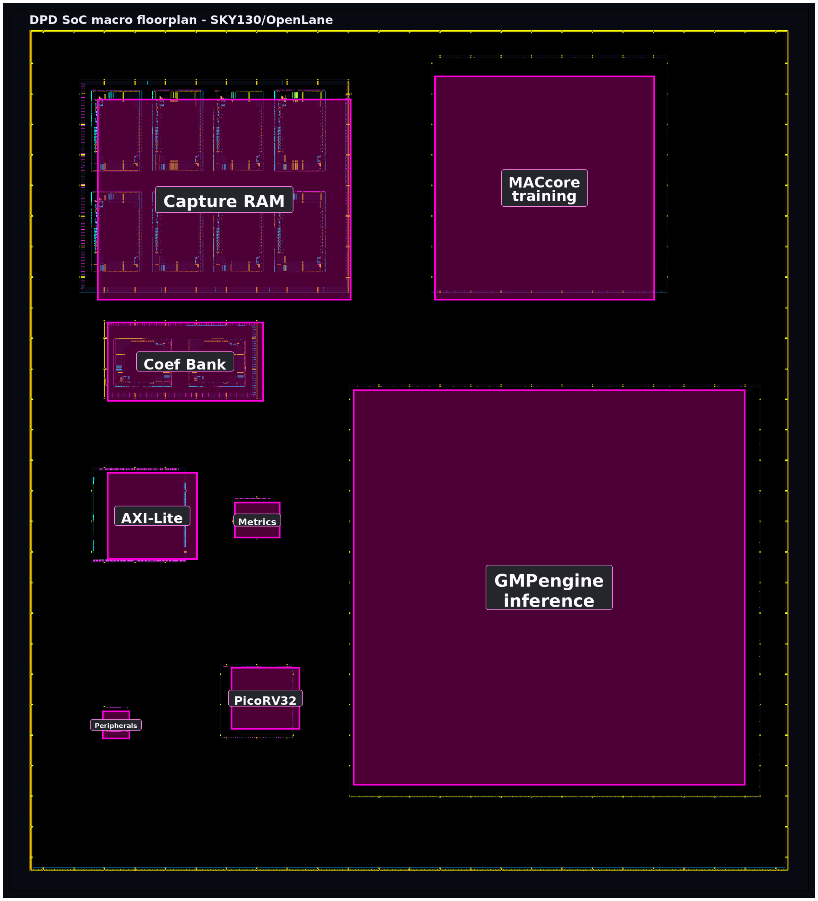
[picture p12: figure]

(a) Floorplan manual preliminar. | (b) Estudo de organização macro-level no OpenLane.

Figura 3: Estudos de floorplan: proposta manual e organização macro-level experimental. A figura não representa top-level com padframe ou timing fechado.

Tabela II: Baseline física comum das macros em OpenLane/SKY130, com período-alvo de 10 ns.

Bloco | Células | Área (mm²
| | ) | Setup (ns) | Hold (ns) | Célula dominante
PicoRV32 | 10114 | 0.377 | +3.41 | +0.15 | buf_1 (2422)
AXI control | 1713 | 0.640 | +3.58 | +0.21 | buf_1 (395)
Periféricos | 755 | 0.044 | +4.21 | +0.19 | dfrtp_2 (183)
MetricEngine | 2593 | 0.116 | +2.94 | +0.24 | nand2_2 (272)
Capture RAM | 741 | 4.140 | +3.93 | +0.26 | dfxtp_2 (320)
Coef Bank | 154 | 0.845 | +1.84 | +1.65 | buf_1 (56)
GMPengine | 223170 | 11.497 | +3.16 | +0.09 | nand2_2 (79930)
MACcore | 131048 | 7.758 | +1.47 | +0.16 | nand2_2 (35921)

evidência de signoff, e nenhuma frequência máxima é inferida a partir desses valores intermediários.
O menor setup observado foi de +1,47 ns no MACcore, enquanto o menor hold foi de +0,09 ns no GMPengine. Esses resultados demonstram que as oito macros alcançaram uma baseline física comparável no alvo de 100 MHz. Entretanto, não demonstram fechamento do top-level, pois interconexões hierárquicas, árvore de clock, parasitas entre macros, interfaces externas e rede de alimentação alteram o problema de temporização. Por esse motivo, resultados de tentativas do top em checkpoints ou períodos diferentes não são combinados nesta avaliação.

IX. DISCUSSÃO

Os resultados mostram que a maior dificuldade do projeto não está apenas no algoritmo, mas no contrato entre algoritmo, quantização e implementação física. O OpenDPD indicou que o GMP com 39 termos é adequado para o dataset estudado, mas a implementação fiel desse modelo em SKY130 exige multiplicações complexas, cálculo de magnitude, potências e acumulação de muitos termos. A serialização em quatro fases reduziu área e permitiu avançar no fluxo OpenLane, mantendo throughput arquitetural nominal de 25 MS/s em 100 MHz. Ainda assim, resultados positivos em macros isoladas não garantem fechamento automático do chip: redes de status, fronteiras entre macros, clock tree, RC parasitas e constraints de interface passam a dominar o STA do top.

O MetricEngine ilustra uma decisão recorrente em hardware de telecomunicações: nem todas as métricas usadas em software devem ser reproduzidas em tempo real no chip. NMSE, EVM e ACLR continuam adequadas para análise offline e documentação, enquanto métricas L1/EWMA são mais apropriadas para supervisão embarcada. O MACcore segue a mesma filosofia: ele não implementa um LS/RLS matricial completo, mas uma atualização block-NLMS sintetizável que pode operar em janelas capturadas sem perturbar o caminho de transmissão.
Na etapa física, a divisão hierárquica permitiu medir separadamente controle, memórias, inferência e treinamento. Essa organização também expôs a diferença entre validar o contrato local de cada macro e fechar o sistema completo. Assim, os resultados apresentados constituem uma avaliação física preliminar dos blocos, não uma implementação de circuito integrado pronta para fabricação.
X. TRABALHOS FUTUROS
O primeiro trabalho futuro de integração física é construir e validar um top-level conectado a partir das oito macros da baseline de 100 MHz. Essa etapa deve incluir constraints completas das interfaces, clock tree hierárquica, roteamento detalhado, extração de parasitas e STA RCX multicorner sem violações de setup, hold, slew ou capacitância. Somente depois desse fechamento será possível consolidar a frequência física de operação e verificar se o contrato I I = 4 sustenta 24 MS/s no chip completo.
Em seguida, deve ser implementado o padframe com células de IO compatíveis com SKY130, incluindo pads de alimentação e terra, proteção ESD, clamps, fillers, corners e separação adequada entre domínios do núcleo e de IO. O pinout preliminar considera encapsulamento aQFN/DRQFN-128 e exposed pad conectado ao terra, mas a atribuição final depende de análise de corrente, integridade de sinal, carga do encapsulamento e estratégia de DFT.
O fechamento físico final também requer análise de potência com atividade representativa, IR drop, eletromigração, dissipação térmica, antenna checks, DRC, LVS, XOR, CVC/ERC e simulação gate-level com atrasos SDF. Em paralelo, a validação algorítmica deve ser ampliada com datasets que contenham quadros ATSC 3.0 completos, múltiplas janelas independentes e diferentes condições de potência, ganho e temperatura do PA. Essas etapas são necessárias antes de classificar o projeto como candidato a signoff ou fabricação.

XI. CONCLUSÃO
Este trabalho consolidou uma cadeia de desenvolvimento para DPD aplicada a transmissores de televisão digital de próxima geração, conectando geração de dataset, treinamento OpenDPD, implementação HDL e avaliação física preliminar em SKY130. O estudo definiu um contrato técnico claro: sinal I/Q em 24 MS/s, amostras Q1.15, coeficientes Q2.16, modelo GMP de 39 termos complexos, treinamento block-NLMS em background e métricas leves para supervisão.
A validação HDL confirmou a coerência funcional dos blocos críticos e do fluxo integrado de operação, incluindo bypass inicial, captura, treinamento, escrita de coeficientes, troca sincronizada de banco, inferência DPD e solicitação de retreinamento. A avaliação OpenLane produziu uma baseline comparável para oito macros em 100 MHz, com setup e hold positivos no checkpoint single-corner pós-global-route. O resultado estabelece uma base experimental para integração física, mas não constitui fechamento temporal do top-level, signoff ou circuito pronto para fabricação.

REFERÊNCIAS

[1] OpenROAD Project and Efabless, “OpenLane: Automated RTL to GDSII Flow,” GitHub repository, 2026.
[2] SkyWater Technology and Google, SkyWater SKY130 Open Source PDK, SkyWater Technology and Google, 2026.
[3] Y. Wu, G. D. Singh, M. Beikmirza, L. C. N. de Vreede, M. Alavi, and C. Gao, “OpenDPD: An Open-Source End-to-End Learning and Benchmarking Framework for Wideband Power Amplifier Modeling and Digital Pre-Distortion,” arXiv preprint arXiv:2401.08318, 2024.
[4] TU Delft EMI Lab, “OpenDPD Repository,” GitHub repository, 2026.
[5] GNU Radio Project, “GNU Radio: The Free and Open Software Radio Ecosystem,” Project website, 2026.
[6] R. Economos, “gr-atsc3: ATSC 3.0 Transmitter for GNU Radio,” GitHub repository, 2026.
[7] Forum SBTVD, SBTVD TV 3.0 Operational Guide 01: Physical Layer, Forum do Sistema Brasileiro de TV Digital Terrestre, 2026.
[8] Forum SBTVD, “SBTVD TV 3.0 Phase 3 Physical Layer Lab Test Report,” Forum do Sistema Brasileiro de TV Digital Terrestre, Tech. Rep., 2023.
[9] Forum SBTVD, “SBTVD TV 3.0 Phase 3 Physical Layer Field Test Report,” Forum do Sistema Brasileiro de TV Digital Terrestre, Tech. Rep., 2024.
[10] ATSC, A/300:2024-04, ATSC 3.0 System, Advanced Television Systems Committee, 2024.
[11] ATSC, A/321:2024-04, System Discovery and Signaling, Advanced Television Systems Committee, 2024.
[12] ATSC, A/322:2024-09, Physical Layer Protocol, Advanced Television Systems Committee, 2024.
[13] ATSC, A/324:2024-04, Scheduler/Studio to Transmitter Link, Advanced Television Systems Committee, 2024.
[14] ABNT, ABNT NBR 25601:2025, TV 3.0 – Camada fisica, Associacao Brasileira de Normas Tecnicas, 2025.
