ausilon/VLSI-Design/Digital-Pre-Distortion/docs/figures/dpd_rtl_v2_block_diagram.png

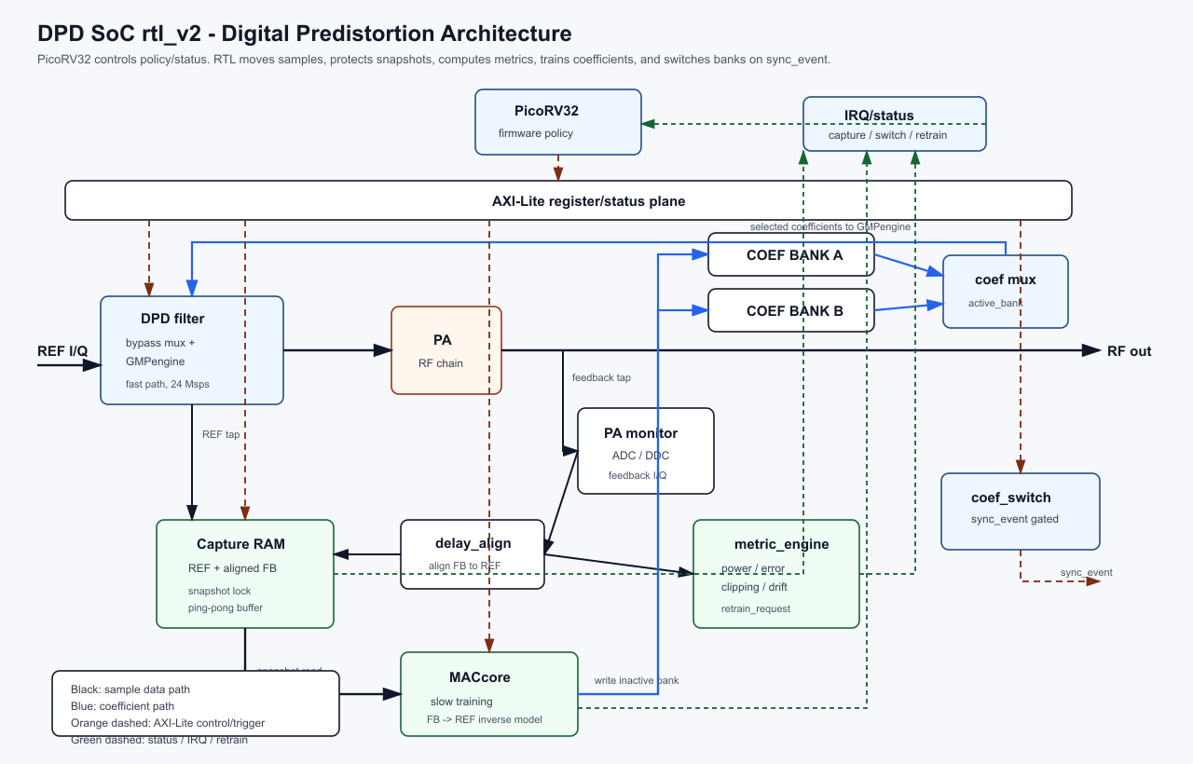
Digital-Pre-Distortion/docs/figures/dpd_rtl_v2_block_diagram.png
