ausilon/VLSI-Design/Digital-Pre-Distortion/docs/figures/dpd_soc_tapeout_top_full05_article_contrast.png

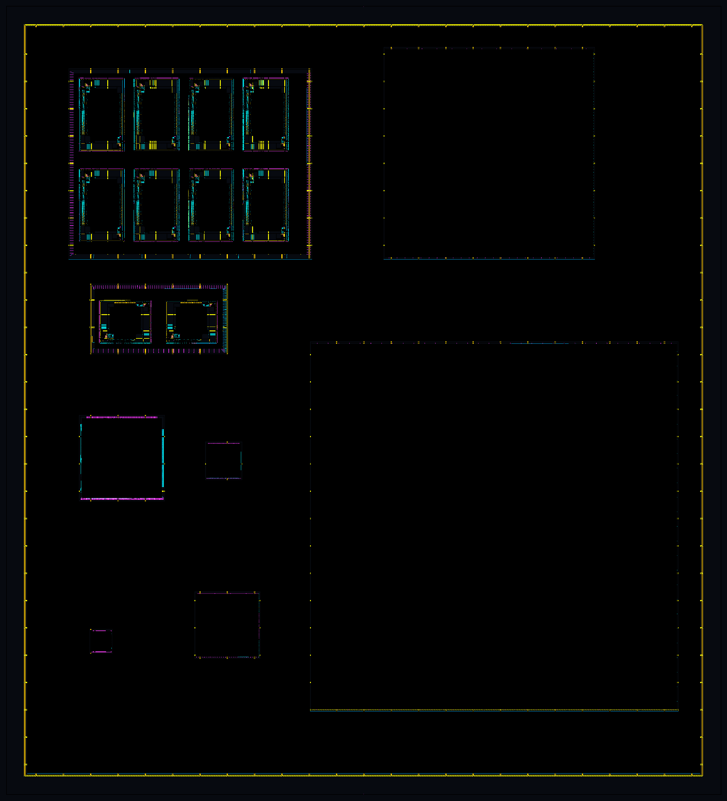
Digital-Pre-Distortion/docs/figures/dpd_soc_tapeout_top_full05_article_contrast.png
