ausilon/VLSI-Design/Digital-Pre-Distortion/openlane/dpd_peripherals_100m/src/irq_status_ctrl.v

// ============================================================
// irq_status_ctrl.v - IRQ/status aggregation for DPD subsystem
// ============================================================
module irq_status_ctrl (
    input  wire clk,
    input  wire resetn,
    input  wire clear_pulse,
    input  wire [31:0] w1c,
    input  wire [31:0] mask,
    input  wire capture_done,
    input  wire coef_switch_done,
    input  wire metrics_valid,
    input  wire metric_retrain_request,
    output reg  [31:0] status,
    output wire irq,
    output wire retrain_request
);
    assign irq = |(status & mask);
    assign retrain_request = status[2];

    always @(posedge clk or negedge resetn) begin
        if (!resetn) begin
            status <= 32'd0;
        end else begin
            if (clear_pulse)
                status <= 32'd0;
            else begin
                status <= status & ~w1c;
                if (capture_done)      status[0] <= 1'b1;
                if (coef_switch_done)  status[1] <= 1'b1;
                if (metrics_valid && metric_retrain_request)
                    status[2] <= 1'b1;
            end
        end
    end
endmodule
