ausilon/VLSI-Design/Digital-Pre-Distortion/openlane/dpd_capture_ram_macro_100m/src/sky130_sram_blackbox.v

(* blackbox *)
module sky130_sram_2kbyte_1rw1r_32x512_8 (
    input  wire        clk0,
    input  wire        csb0,
    input  wire        web0,
    input  wire [3:0]  wmask0,
    input  wire [8:0]  addr0,
    input  wire [31:0] din0,
    output wire [31:0] dout0,
    input  wire        clk1,
    input  wire        csb1,
    input  wire [8:0]  addr1,
    output wire [31:0] dout1
);
endmodule

(* blackbox *)
module sky130_fd_sc_hd__dlygate4sd3_1 (
    input  wire A,
    output wire X
);
endmodule
