ausilon/VLSI-Design/Digital-Pre-Distortion/openlane/dpd_soc_tapeout_top_100m/src/sky130_reset_buffer_blackbox.v

// Elaboration stub only. Timing, function and physical geometry are supplied
// by the official sky130_fd_sc_hd Liberty and LEF views in OpenLane.
/* verilator lint_off UNUSEDSIGNAL */
/* verilator lint_off UNDRIVEN */
(* blackbox *)
module sky130_fd_sc_hd__buf_8 (
    input  wire A,
    output wire X
);
endmodule
/* verilator lint_on UNDRIVEN */
/* verilator lint_on UNUSEDSIGNAL */
