ausilon/VLSI-Design/Digital-Pre-Distortion/openlane/dpd_pico_100m/src/picorv32_ol_wrapper.v

// OpenLane child macro wrapper for the PicoRV32 control core.
module picorv32_ol_wrapper (
    input  wire        clk,
    input  wire        resetn,
    input  wire        mem_ready,
    input  wire [31:0] mem_rdata,
    input  wire [31:0] irq,
    output wire        trap,
    output wire        mem_valid,
    output wire        mem_instr,
    output wire [31:0] mem_addr,
    output wire [31:0] mem_wdata,
    output wire [3:0]  mem_wstrb,
    output wire [31:0] eoi
);
    wire        mem_la_read;
    wire        mem_la_write;
    wire [31:0] mem_la_addr;
    wire [31:0] mem_la_wdata;
    wire [3:0]  mem_la_wstrb;
    wire        pcpi_valid;
    wire [31:0] pcpi_insn;
    wire [31:0] pcpi_rs1;
    wire [31:0] pcpi_rs2;
    wire        trace_valid;
    wire [35:0] trace_data;

    picorv32 #(
        .ENABLE_COUNTERS(0),
        .ENABLE_COUNTERS64(0),
        .ENABLE_IRQ(1),
        .ENABLE_IRQ_TIMER(0),
        .ENABLE_MUL(0),
        .ENABLE_FAST_MUL(0),
        .ENABLE_DIV(0),
        .ENABLE_PCPI(0),
        .COMPRESSED_ISA(0),
        .CATCH_MISALIGN(0),
        .CATCH_ILLINSN(1),
        .PROGADDR_RESET(32'h0000_0000),
        .PROGADDR_IRQ(32'h0000_0010)
    ) u_picorv32 (
        .clk(clk),
        .resetn(resetn),
        .trap(trap),
        .mem_valid(mem_valid),
        .mem_instr(mem_instr),
        .mem_ready(mem_ready),
        .mem_addr(mem_addr),
        .mem_wdata(mem_wdata),
        .mem_wstrb(mem_wstrb),
        .mem_rdata(mem_rdata),
        .mem_la_read(mem_la_read),
        .mem_la_write(mem_la_write),
        .mem_la_addr(mem_la_addr),
        .mem_la_wdata(mem_la_wdata),
        .mem_la_wstrb(mem_la_wstrb),
        .pcpi_valid(pcpi_valid),
        .pcpi_insn(pcpi_insn),
        .pcpi_rs1(pcpi_rs1),
        .pcpi_rs2(pcpi_rs2),
        .pcpi_wr(1'b0),
        .pcpi_rd(32'd0),
        .pcpi_wait(1'b0),
        .pcpi_ready(1'b0),
        .irq(irq),
        .eoi(eoi),
        .trace_valid(trace_valid),
        .trace_data(trace_data)
    );
endmodule
