ausilon/VLSI-Design/Digital-Pre-Distortion/openlane/dpd_soc_macro_top_100m/src/macro_blackboxes.v

(* blackbox *) module picorv32_ol_wrapper (); endmodule
(* blackbox *) module axi_ctrl_wrapper (); endmodule
(* blackbox *) module peripherals_wrapper (); endmodule
(* blackbox *) module metric_engine (); endmodule
(* blackbox *) module gmp_engine_ol_wrapper (); endmodule
(* blackbox *) module capture_ram_macro (); endmodule
(* blackbox *) module coef_bank_macro (); endmodule
(* blackbox *) module mac_engine (); endmodule
