ausilon/VLSI-Design/(commit log)

2026-07-25 docs: consolidate DPD VLSI proof of concept
    [coef_bank_openDPD_audit.csv, expected_capture_delay0.csv, macro_placement.cfg, pin_order.cfg, samples.csv]
2026-07-31 docs(openlane): sync current 100 MHz physical design
    [macro_placement.cfg, pin_order.cfg]
2026-08-04 docs(dpd): separate current status from future work
